TUDSSL/Botoks/hardware/Bill-of-materials.xlsx

Qty | Reference(s) | Value | Footprint | Datasheet | MPN | Digikey | Mouser
1 | AE1 | W3016 | jaspers_footprints:W3016 | https://productfinder.pulseeng.com/product/W3016 | W3016
20 | C1, C4, C5, C6, C7, C22, C23, C24, C27, C28, C29, C30, C31, C32, C33, C34, C37, C38, C44, C45 | 100nF | Capacitor_SMD:C_0402_1005Metric | ~ | GCM155R71C104KA55D | 490-4759-1-ND | 81-GCM155R71C104KA5D
6 | C2, C3, C17, C21, C39, C43 | DNP | Capacitor_SMD:C_0402_1005Metric | ~
2 | C8, C11 | 39pF | Capacitor_SMD:C_0402_1005Metric | ~ | 04025A390JAT2A | 478-1077-1-ND | 581-04025A390J
3 | C9, C10, C14 | 100pF | Capacitor_SMD:C_0402_1005Metric | ~ | GCM1555C1H101JA16D | 490-10669-1-ND | 81-GCM1555C1H101JA6D
2 | C12, C13 | 0.7pF | Capacitor_SMD:C_0402_1005Metric | ~ | 500R07S0R7AV4T | 712-1249-1-ND | 609-500R07S0R7AV4T
2 | C15, C18 | 2.2uF | Capacitor_SMD:C_0402_1005Metric | ~ | GRM155R61C225KE11D | 490-10695-1-ND | 81-GRM155R61C225KE1D
1 | C16 | C | Capacitor_SMD:C_0402_1005Metric | ~ | LQW15AN4N3G8ZD | 490-15466-1-ND
1 | C20 | 10u | Capacitor_SMD:C_0805_2012Metric | ~ | CL21A106KPFNNNG | 1276-6456-1-ND
1 | C35 | 2.2nF | Capacitor_SMD:C_0805_2012Metric | ~ | GRM2165C1H222FA01D | 490-6443-1-ND | 81-GRM2165C1H222FA1D
1 | C36 | 22nF | Capacitor_SMD:C_0805_2012Metric | ~ | GRM21B5C1H223JA01L | 490-1644-1-ND | 81-GRM215C1H223JA01L
1 | C25 | 220nF | Capacitor_SMD:C_0805_2012Metric | ~ | GCM21BR71H224KA37L | 490-4970-1-ND | 81-GCM21BR71H224K37L
1 | C26 | 2.2uF | Capacitor_SMD:C_0805_2012Metric | ~ | GCM21BR71E225KA73L | 490-4787-1-ND | 81-GCM21BR71E225KA3L
1 | C40 | 2.2nF | Capacitor_SMD:C_0402_1005Metric | ~ | GCM155R71H222KA37D | 490-4914-1-ND | 81-GCM155R71H222K37D
1 | C41 | 22uF | Capacitor_SMD:C_0603_1608Metric | ~ | GRM187R61A226ME15D | 490-13243-1-ND | 81-GRM187R61A226ME5D
1 | C42 | 100uF | Capacitor_SMD:C_0805_2012Metric | ~ | GRM21BR60J107ME15L | 490-13981-1-ND | 81-GRM21BR60J107ME5L
4 | D1, D2, D3, D4 | BAS40-02V-V-G-08 | Diode_SMD:D_SOD-523 | http://www.vishay.com/docs/82391/bas4002v.pdf | BAS40-02V-V-G-08 | BAS40-02V-V-G-08GICT-ND | 78-BAS40-02V-V-G-08
1 | F1 | SF16-0868M4 | jaspers_footprints:SF16-0868M4 | https://global.kyocera.com/prdct/electro/product/pdf/sf14_sf16_short.pdf | SF16-0868M4 | 478-6488-1-ND | 581-SF16-0868M4UU01
1 | J1 | 952-3602-ND | Connector_PinHeader_1.27mm:PinHeader_1x06_P1.27mm_Vertical | ~ | M50-3530642 | 952-3602-ND | 855-M50-3530642
1 | J2 | Conn_01x03 | Connector_PinHeader_1.00mm:PinHeader_1x03_P1.00mm_Vertical | ~ | SMH100-LPSE-S40-ST-BK | S9219-ND
2 | J3, J5 | Conn_01x02 | Connector_PinHeader_1.00mm:PinHeader_1x02_P1.00mm_Vertical | ~
1 | J4 | MM8030-2610 | jaspers_footprints:MM8030 |  | MM8030-2610 | 490-5907-1-ND‎ | 81-MM8030-2610RK0
2 | L1, L2 | 8.7nH | Inductor_SMD:L_0402_1005Metric | ~ | LQW15AN8N7G00D | 490-6851-1-ND | 81-LQW15AN8N7G00D
2 | L3, L4 | 39nH | Inductor_SMD:L_0402_1005Metric | ~ | LQW15AN39NG8ZD | 490-15413-1-ND | 81-LQW15AN39NG8ZD
1 | L5 | 19nH | Inductor_SMD:L_0402_1005Metric | ~ | LQW15AN19NG00D | 490-6778-1-ND | 81-LQW15AN19NG00D
1 | L6 | 7.5nH | Inductor_SMD:L_0402_1005Metric | ~ | LQW15AN7N5G00D | 490-6846-1-ND | 81-LQW15AN7N5G00D
1 | R1 | 49.9k ±1% | Resistor_SMD:R_0402_1005Metric | ~ | ERJ-2RKF4992X | P49.9KLCT-ND | 667-ERJ-2RKF4992X
11 | R2, R4, R5, R6, R7, R8, R11, R22, R23, R24, R25 | 10M | Resistor_SMD:R_0402_1005Metric | ~ | RC1005F106CS | 1276-3434-1-ND
5 | R9, R10, R26, R27, R37 | 100 | Resistor_SMD:R_0402_1005Metric | ~ | ERJ-2GEJ101X | P100JCT-ND | 667-ERJ-2GEJ101X
4 | R13, R14, R30, R31 | 22M | Resistor_SMD:R_0805_2012Metric | ~ | RMCF0805FT22M0 | RMCF0805FT22M0CT-ND
1 | R15 | 9.1M | Resistor_SMD:R_0402_1005Metric | ~ | ERJ-2GEJ915X | P9.1MJCT-ND | 667-ERJ-2GEJ915X
1 | R16 | 2.4M | Resistor_SMD:R_0402_1005Metric | ~ | ERJ-2GEJ245X | P2.4MJCT-ND | 667-ERJ-2GEJ245X
1 | R32 | 47k | Resistor_SMD:R_0402_1005Metric | ~ | ERJ-2GEJ473X | P47KJCT-ND | 667-ERJ-2GEJ473X
1 | R33 | 1.5M | Resistor_SMD:R_0402_1005Metric | ~ | ERJ-2GEJ155X | P1.5MJCT-ND | 667-ERJ-2GEJ155X
1 | R34 | 360k | Resistor_SMD:R_0402_1005Metric | ~ | ERJ-2RKF3603X | P360KLCT-ND | 667-ERJ-2RKF3603X
1 | R35 | 1.1M | Resistor_SMD:R_0402_1005Metric | ~ | AC0402FR-071M1L | YAG5647CT-ND | 603-AC0402FR-071M1L
1 | R36 | 10k | Resistor_SMD:R_0402_1005Metric | ~ | ERJ-2RKF1002X | P10.0KLCT-ND | 667-ERJ-2RKF1002X
1 | SC1 | KXOB25-02X8F | jaspers_footprints:KXOB25-02X8F | ~ | KXOB25-02X8F | KXOB25-02X8F-ND
2 | U1, U18 | S-1313A22-N4T1U3 | Package_TO_SOT_SMD:SC-82AB | https://www.ablic.com/en/doc/datasheet/voltage_regulator/S1313_E.pdf | S-1313A22-N4T1U3 | 1662-2988-1-ND | 628-S-1313A22-N4T1U3
1 | U2 | ZL70550 | jaspers_footprints:QFN-32-1EP_5x5mm_P0.5mm_EP3.45x3.45mm_ThermalVias_0.3mm_Drill | https://www.microsemi.com/document-portal/doc_download/135816-microsemi-zl70550-ultra-low-power-sub-ghz-rf-transceiver-datasheet | ZL70550LDF1 |  | 494-ZL70550LDF1
4 | U3, U6, U10, U14 | TS3A4751 | Package_DFN_QFN:Texas_S-PVQFN-N14_ThermalVias | http://www.ti.com/general/docs/lit/getliterature.tsp?genericPartNumber=ts3a4751&fileType=pdf | TS3A4751RGYR | 296-24477-1-ND | 595-TS3A4751RGYR
3 | U4, U11, U12 | SN74AUP2G79DCU | Package_SO:VSSOP-8_2.4x2.1mm_P0.5mm | http://www.ti.com/lit/ds/symlink/sn74aup2g79.pdf | SN74AUP2G79DCUR | 296-25598-1-ND | 595-SN74AUP2G79DCUR
2 | U5, U13 | SN74AUP2G00DCU | Package_SO:VSSOP-8_2.4x2.1mm_P0.5mm | http://www.ti.com/lit/ds/symlink/sn74aup2g00.pdf | SN74AUP2G00DCUR | 296-36884-1-ND | 595-SN74AUP2G00DCUR
1 | U7 | MCP1810T-12 | Package_TO_SOT_SMD:SOT-23-5 | http://ww1.microchip.com/downloads/en/DeviceDoc/20005623B.pdf | MCP1810T-12 | - | 579-MCP1810T12IOT
3 | U8, U9, U17 | TLV3691IDCK | jaspers_footprints:Texas_R-PDSO-G5 | http://www.ti.com/lit/ds/symlink/tlv3691.pdf | TLV3691IDCKR | 296-37910-1-ND | 595-TLV3691IDCKR
1 | U15 | MSP430FR5994IRGZ | Package_DFN_QFN:QFN-48-1EP_7x7mm_P0.5mm_EP5.15x5.15mm_ThermalVias | http://www.ti.com/lit/ds/symlink/msp430fr5994.pdf | MSP430FR5994IRGZ | 296-48940-1-ND | 595-P430FR5994IRGZR
1 | U16 | MIC841HYC5 | jaspers_footprints:SC70-5 | http://ww1.microchip.com/downloads/en/DeviceDoc/20005758A.pdf | MIC841HYC5-TR | 576-2923-1-ND | 998-MIC841HYC5TR
1 | Y1 | ECS-240-8-37CKM | jaspers_footprints:ECX-1637 | https://www.ecsxtal.com/store/pdf/ecx-1637.pdf | ECS-240-8-37CKM | XC1543CT-ND | 520-ECS-240-8-37CKM
