TUDSSL/Botoks/hardware/schematic/Botox_Mote.pdf

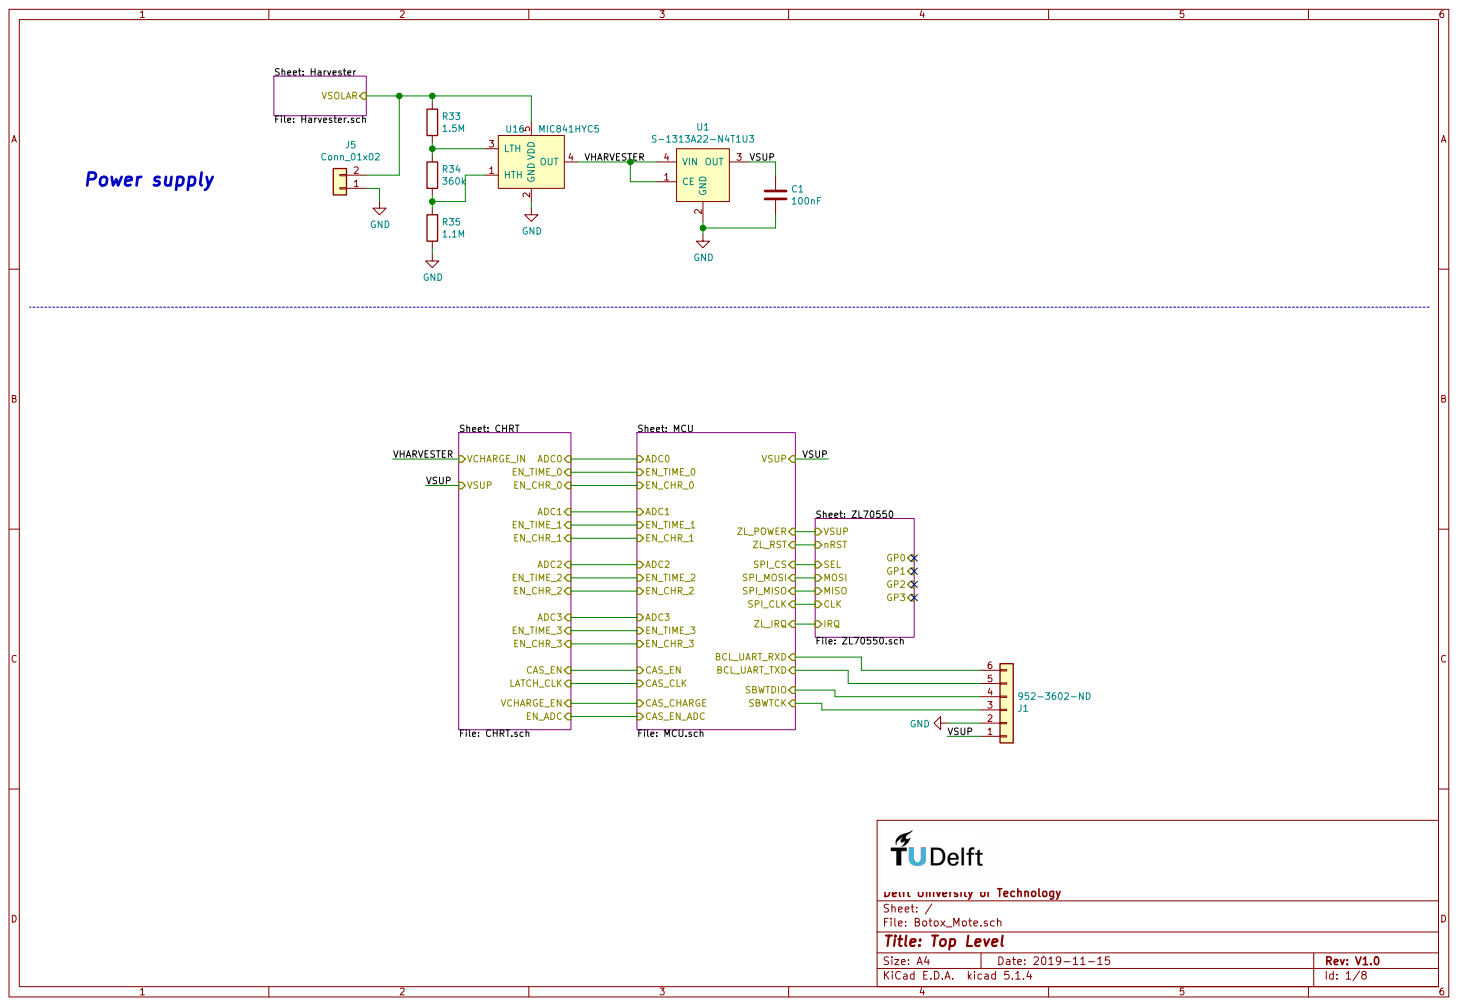
[picture p3: page 1]

Sheet: Harvester File: Harvester.sch VSOLAR

Sheet: ZL70550 File: ZL70550.sch MISO MOSI CLK
VSUP
SEL

File: Botox_Mote.sch Sheet: / Delft University of Technology

Id: 1/8 Title: Top Level

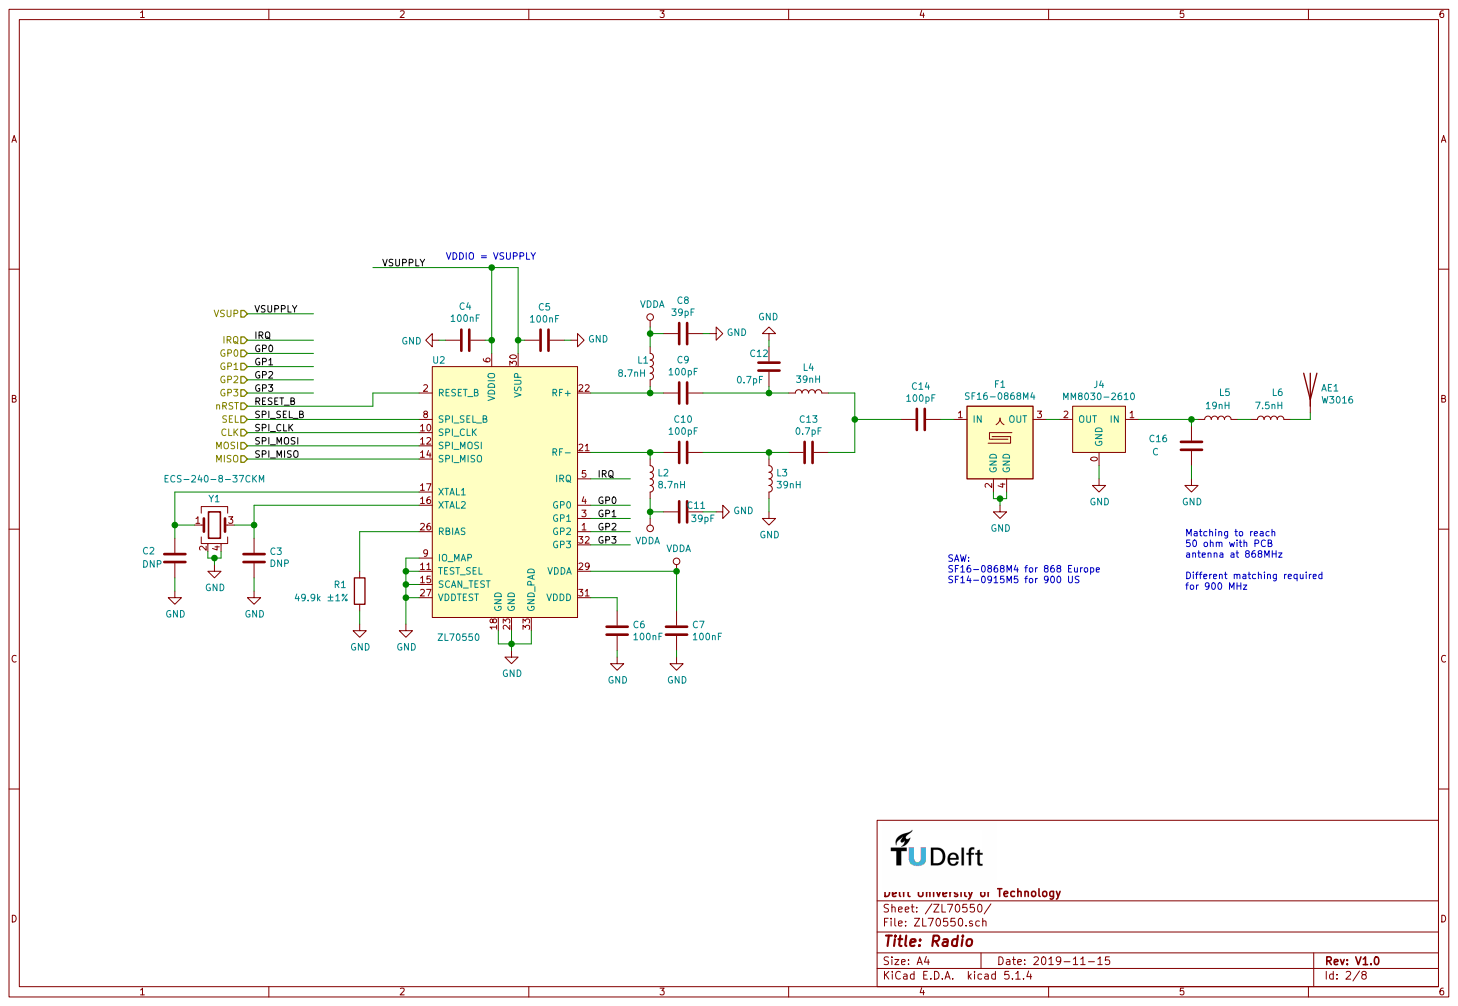
[picture p4: page 2]

for 900 MHz VDDIO = VSUPPLY

50 ohm with PCB
antenna at 868MHz Different matching required

SAW: SF16-0868M4 for 868 Europe SF14-0915M5 for 900 US

File: ZL70550.sch Sheet: /ZL70550/ Delft University of Technology GND

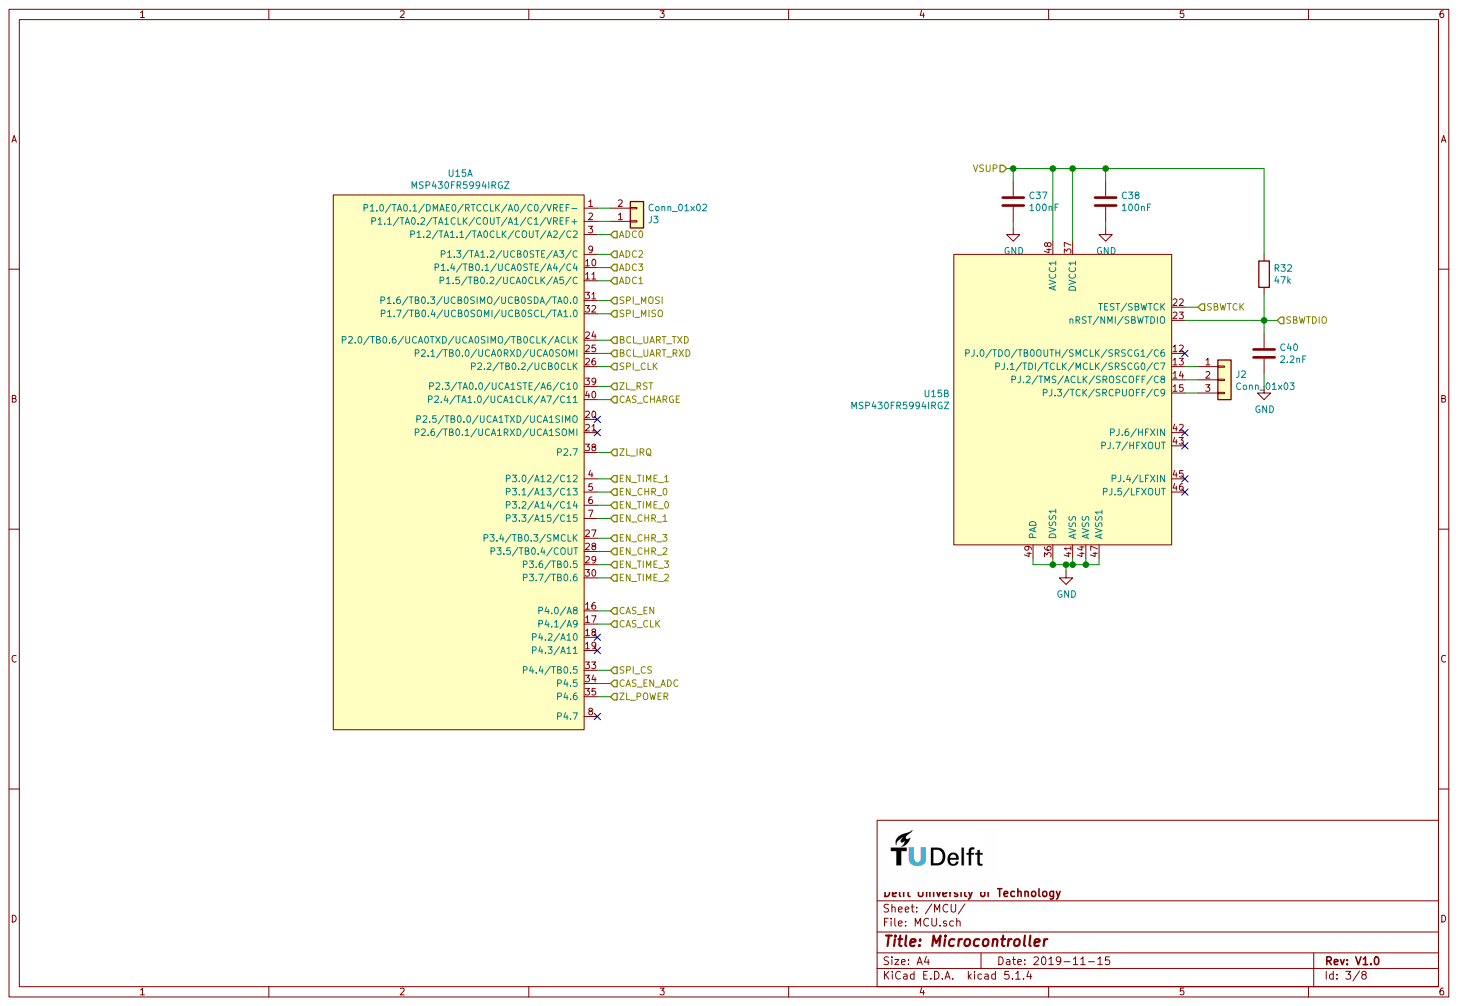
[picture p5: page 3]

Id: 3/8 Title: Microcontroller File: MCU.sch Sheet: /MCU/ Delft University of Technology

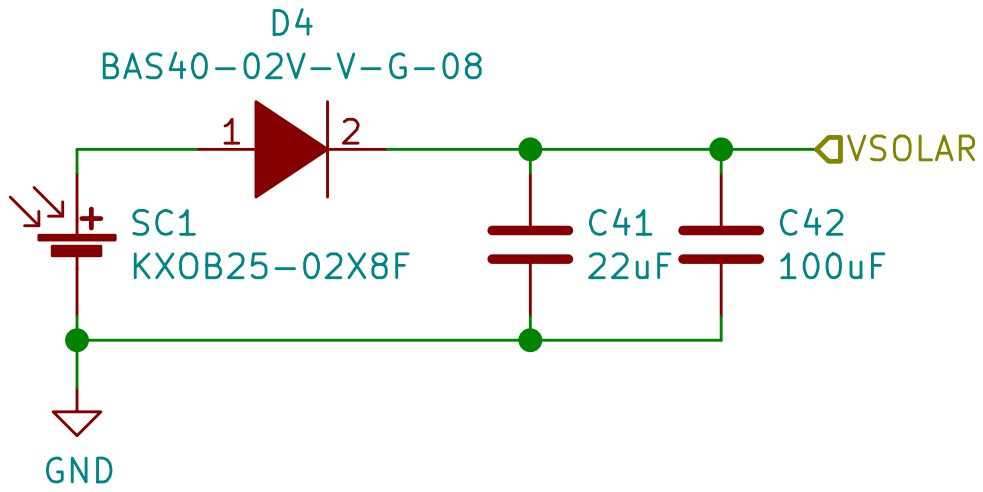
[picture p6: page 4]

Id: 4/8 Title: Solar Energy Harvester File: Harvester.sch Sheet: /Harvester/ Delft University of Technology

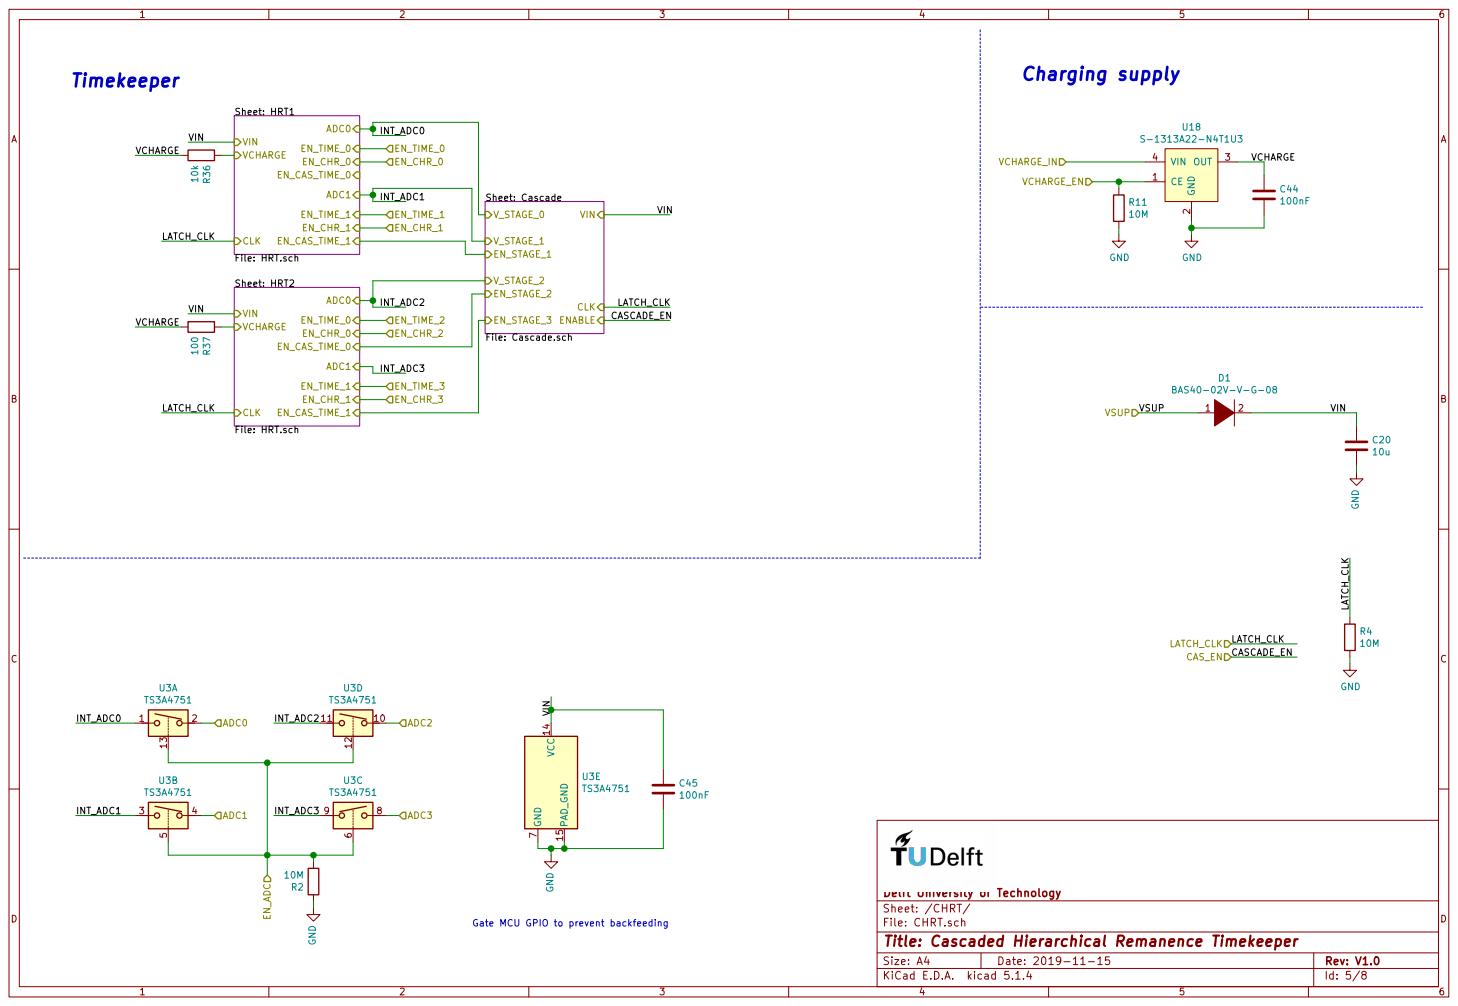
[picture p7: page 5]

Id: 5/8 Title: Cascaded Hierarchical Remanence Timekeeper File: CHRT.sch Sheet: /CHRT/ Delft University of Technology

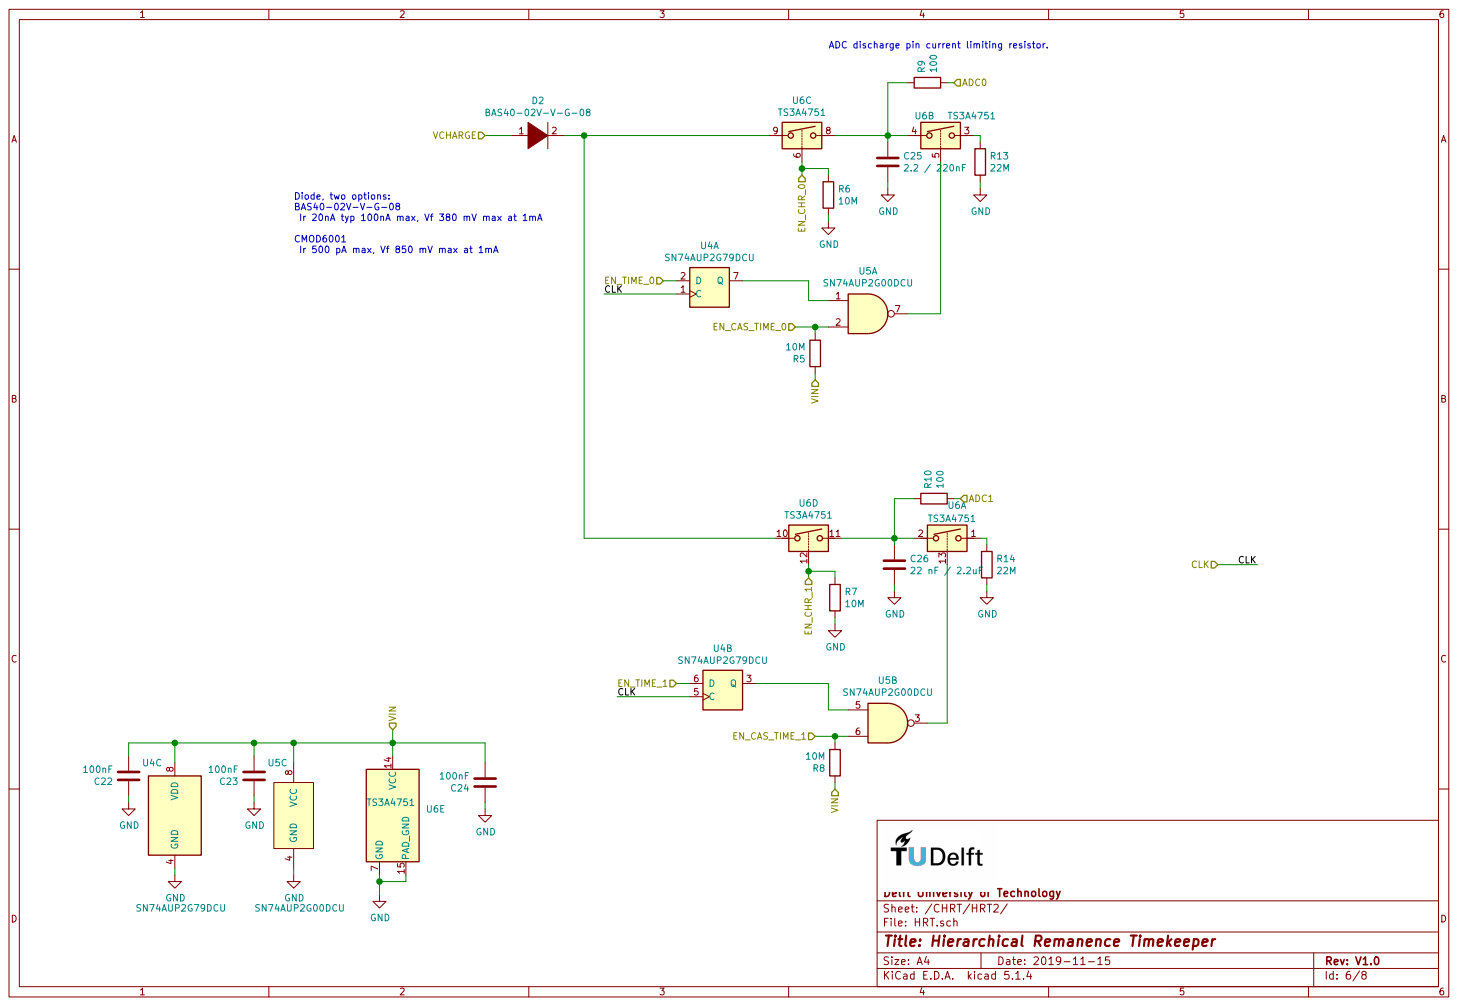
[picture p8: page 6]

Ir 20nA typ 100nA max, Vf 380 mV max at 1mA CMOD6001

Ir 500 pA max, Vf 850 mV max at 1mA

Id: 6/8 Title: Hierarchical Remanence Timekeeper File: HRT.sch Sheet: /CHRT/HRT2/ Delft University of Technology

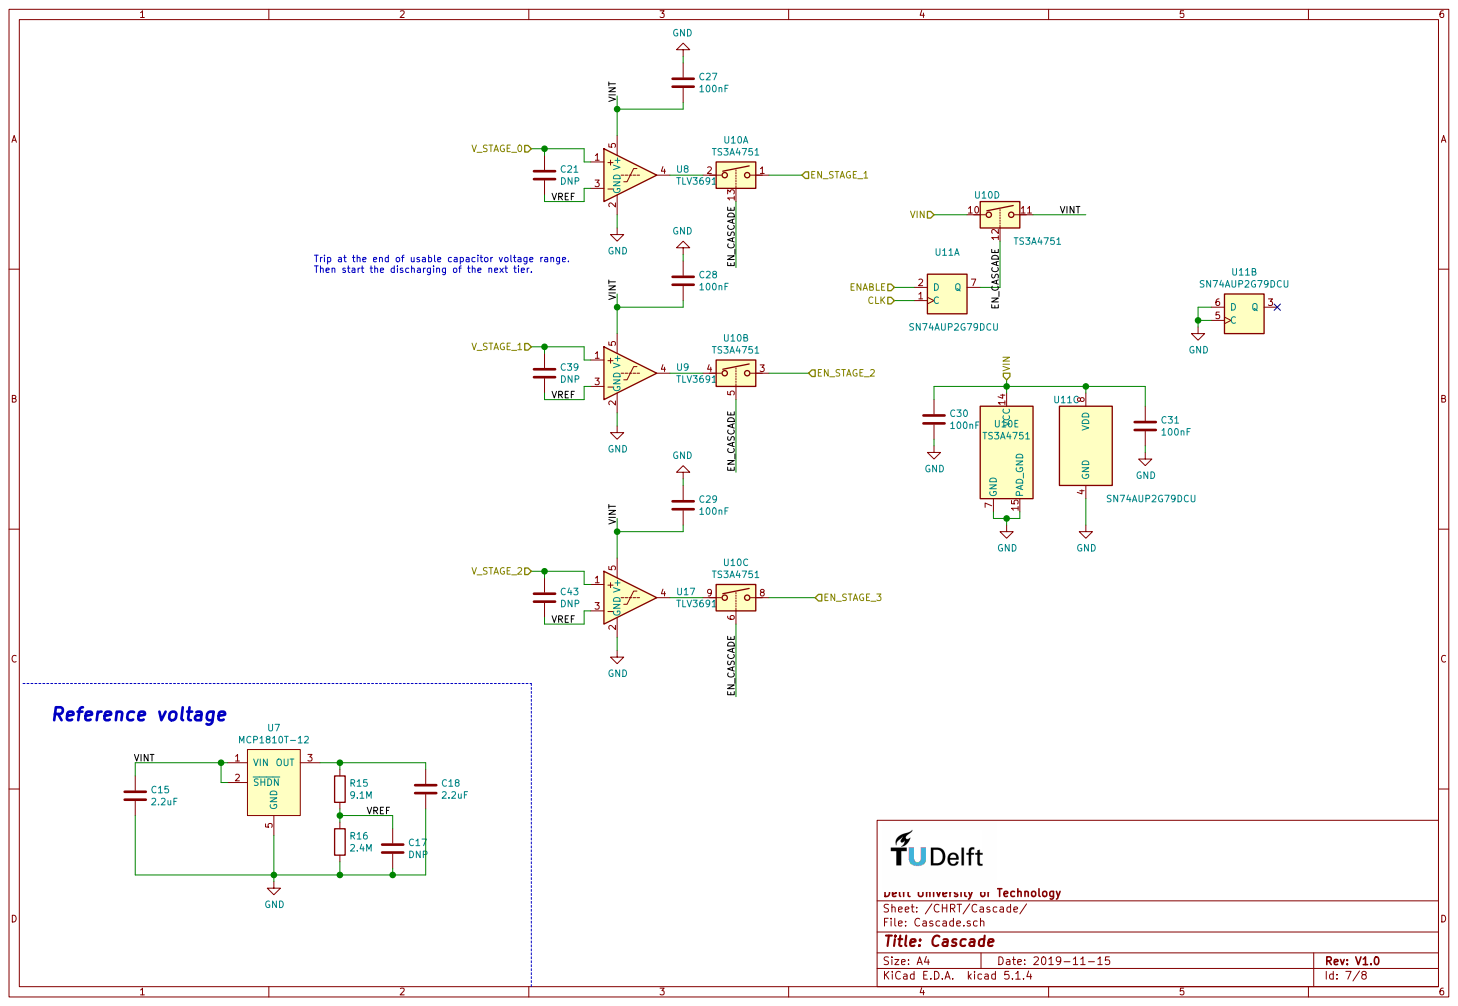
[picture p9: page 7]

Trip at the end of usable capacitor voltage range.
Then start the discharging of the next tier.

File: Cascade.sch Sheet: /CHRT/Cascade/ Delft University of Technology

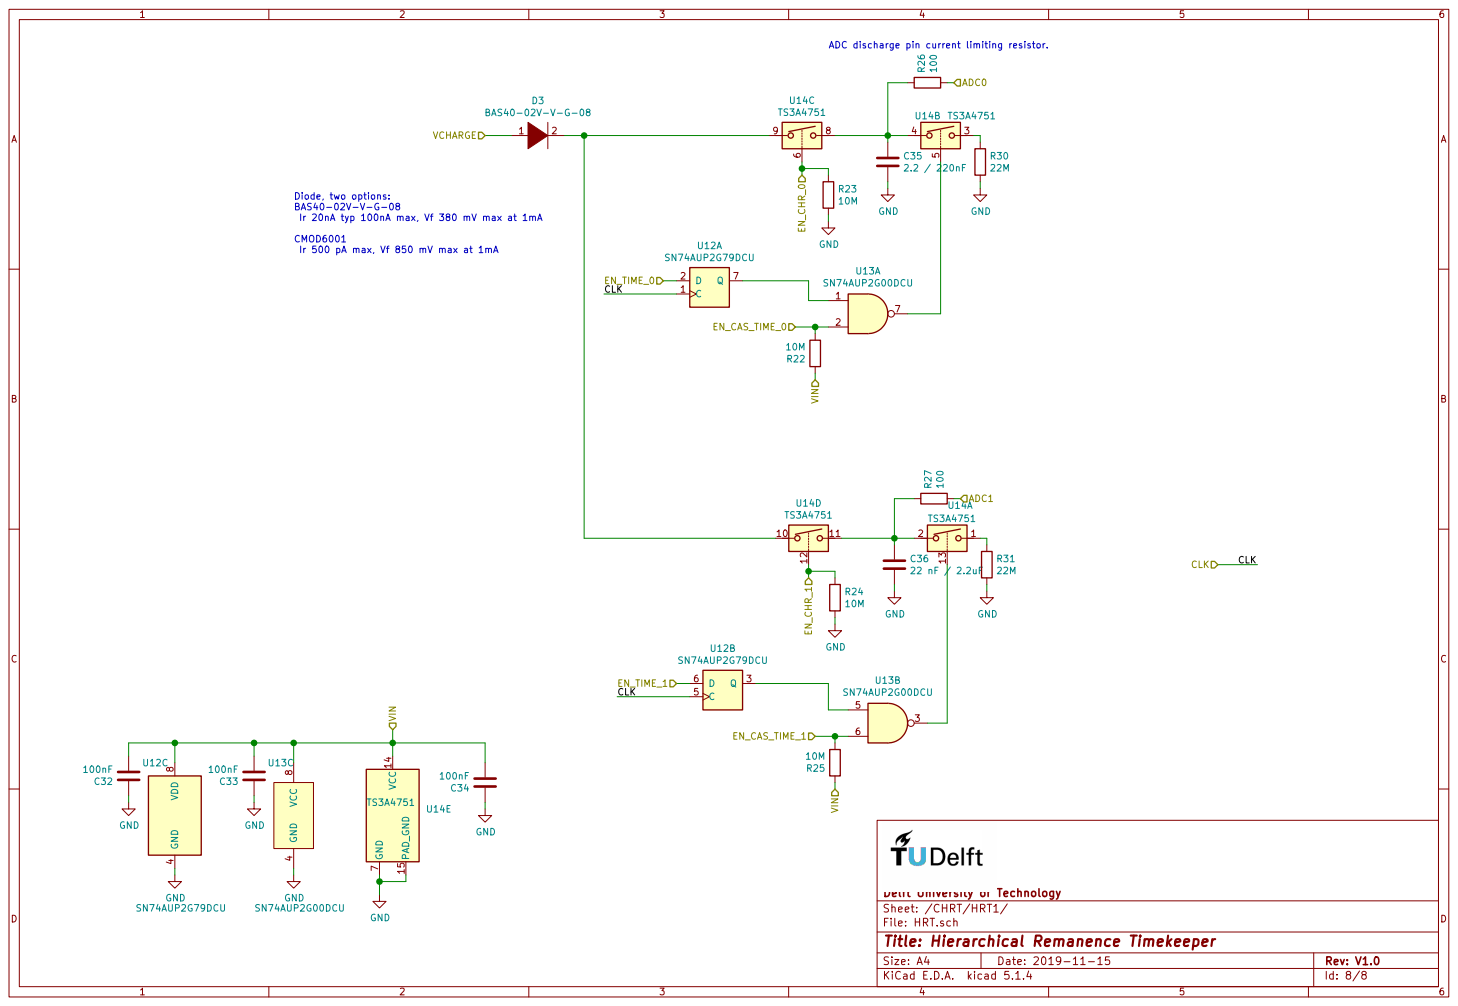
[picture p10: page 8]

Ir 20nA typ 100nA max, Vf 380 mV max at 1mA CMOD6001

Ir 500 pA max, Vf 850 mV max at 1mA

Id: 8/8 Title: Hierarchical Remanence Timekeeper File: HRT.sch Sheet: /CHRT/HRT1/ Delft University of Technology
