TUDSSL/Botoks/hardware/Botox_Mote.kicad_pcb

## KiCad design hardware/Botox_Mote.kicad_pcb (2020-01-19)

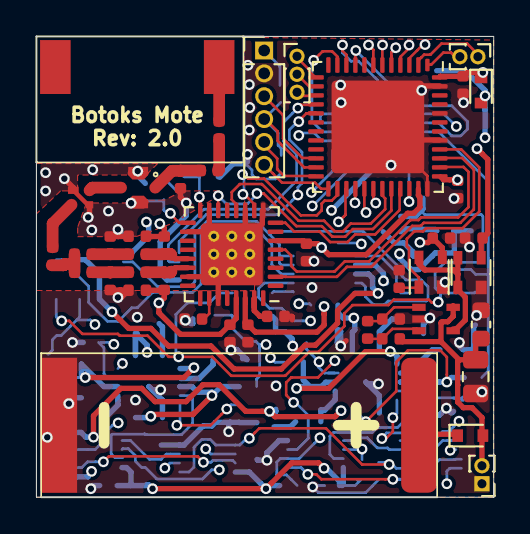
[picture p11: board Botox_Mote.kicad_pcb from above]

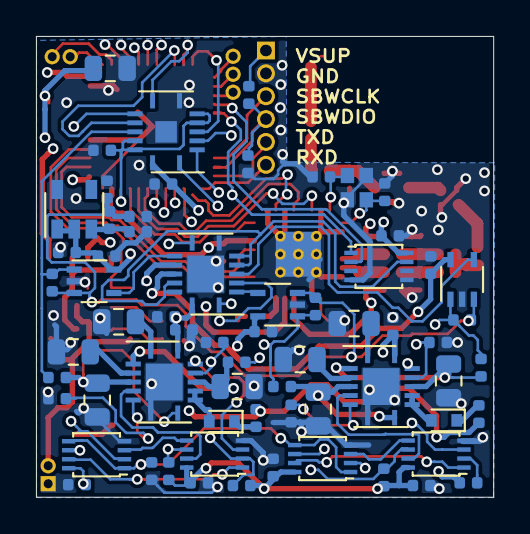
[picture p12: board Botox_Mote.kicad_pcb from below]

Board: 4 copper layers, 25.4 x 25.6 mm, 109 parts (65 on the bottom side), 91 nets.

Parts:
AE1: W3016
C1, C4, C5, C6, C7, C22, C23, C24, C27, C28, C29, C30, C31, C32, C33, C34, C37, C38, C44, C45: 100nF; C_0402_1005Metric
C2, C3, C17, C21, C39, C43: DNP; C_0402_1005Metric
C8, C11: 39pF; C_0402_1005Metric
C9, C10, C14: 100pF; C_0402_1005Metric
C12, C13: 0.7pF; C_0402_1005Metric
C15, C18: 2.2uF; C_0402_1005Metric
C16: C; C_0402_1005Metric
C20: 10u; C_0805_2012Metric
C25, C35: 2.2 / 220nF; C_0805_2012Metric
C26, C36: 22 nF / 2.2uF; C_0805_2012Metric
C40: 2.2nF; C_0402_1005Metric
C41: 22uF; C_0603_1608Metric
C42: 100uF; C_0805_2012Metric
D1, D2, D3, D4: BAS40-02V-V-G-08; D_SOD-523
F1: SF16-0868M4
J1: 952-3602-ND; PinHeader_1x06_P1.27mm_Vertical
J2: Conn_01x03; PinHeader_1x03_P1.00mm_Vertical
J3, J5: Conn_01x02; PinHeader_1x02_P1.00mm_Vertical
J4: MM8030-2610; MM8030
L1, L2: 8.7nH; L_0402_1005Metric
L3, L4: 39nH; L_0402_1005Metric
L5: 19nH; L_0402_1005Metric
L6: 7.5nH; L_0402_1005Metric
R1: 49.9k ±1%; R_0402_1005Metric
R2, R4, R5, R6, R7, R8, R11, R22, R23, R24, R25: 10M; R_0402_1005Metric
R9, R10, R26, R27, R37: 100; R_0402_1005Metric
R13, R14, R30, R31: 22M; R_0805_2012Metric
R15: 9.1M; R_0402_1005Metric
R16: 2.4M; R_0402_1005Metric
R32: 47k; R_0402_1005Metric
R33: 1.5M; R_0402_1005Metric
R34: 360k; R_0402_1005Metric
R35: 1.1M; R_0402_1005Metric
R36: 10k; R_0402_1005Metric
SC1: KXOB25-02X8F
U1, U18: S-1313A22-N4T1U3; SC-82AB
U2: ZL70550; QFN-32-1EP_5x5mm_P0.5mm_EP3.45x3.45mm_ThermalVias_0.3mm_Dri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
U3, U6, U10, U14: TS3A4751; Texas_S-PVQFN-N14
U4, U11, U12: SN74AUP2G79DCU; VSSOP-8_2.4x2.1mm_P0.5mm
U5, U13: SN74AUP2G00DCU; VSSOP-8_2.4x2.1mm_P0.5mm
U7: MCP1810T-12; SOT-23-5
U8, U9, U17: TLV3691IDCK; Texas_R-PDSO-G5
U15: MSP430FR5994IRGZ; QFN-48-1EP_7x7mm_P0.5mm_EP5.15x5.15mm
U16: MIC841HYC5; SC70-5
Y1: ECS-240-8-37CKM; ECX-1637

Connections:
/CHRT/ADC0: U3.2, U15.3
/CHRT/ADC1: U3.4, U15.11
/CHRT/ADC2: U3.10, U15.9
/CHRT/ADC3: U3.8, U15.10
/CHRT/CAS_EN: U11.2, U15.16
/CHRT/Cascade/EN_CASCADE: U10.5, U10.6, U10.12, U10.13, U11.7
/CHRT/Cascade/VINT: C15.1, C27.2, C28.2, C29.2, U7.1, U7.2, U8.5, U9.5, U10.11, U17.5
/CHRT/Cascade/VREF: C17.1, C21.2, C39.2, C43.2, R15.2, R16.1, U8.3, U9.3, U17.3
/CHRT/EN_CHR_0: R23.1, U14.6, U15.5
/CHRT/EN_CHR_1: R24.1, U14.12, U15.7
/CHRT/EN_CHR_2: R6.1, U6.6, U15.28
/CHRT/EN_CHR_3: R7.1, U6.12, U15.27
/CHRT/EN_TIME_0: U12.2, U15.6
/CHRT/EN_TIME_1: U12.6, U15.4
/CHRT/EN_TIME_2: U4.2, U15.30
/CHRT/EN_TIME_3: U4.6, U15.29
/CHRT/HRT1/EN_CAS_TIME_0: R22.2, U13.2
/CHRT/HRT1/EN_CAS_TIME_1: R25.2, U10.1, U13.6
/CHRT/HRT1/VCHARGE: D3.1, R36.1
/CHRT/HRT2/EN_CAS_TIME_0: R5.2, U5.2, U10.3
/CHRT/HRT2/EN_CAS_TIME_1: R8.2, U5.6, U10.8
/CHRT/HRT2/VCHARGE: D2.1, R37.1
/CHRT/INT_ADC0: C21.1, R26.2, U3.1, U8.1
/CHRT/INT_ADC1: C39.1, R27.2, U3.3, U9.1
/CHRT/INT_ADC2: C43.1, R9.2, U3.11, U17.1
/CHRT/INT_ADC3: R10.2, U3.9
/CHRT/VCHARGE: C44.1, R36.2, R37.2, U18.3
/CHRT/VIN: C20.1, C22.2, C23.2, C24.2, C30.1, C31.1, C32.2, C33.2, C34.2, C45.1, D1.2, R5.1, R8.1, R22.1, R25.1, U3.14, U4.8, U5.8, U6.14, U10.10, U10.14, U11.8, U12.8, U13.8, U14.14
/Harvester/VSOLAR: C41.1, C42.1, D4.2, J5.2, R33.1, U16.5
/MCU/BCL_UART_RXD: J1.6, U15.25
/MCU/BCL_UART_TXD: J1.5, U15.24
/MCU/CAS_CHARGE: R11.1, U15.40, U18.1
/MCU/CAS_CLK: R4.1, U4.1, U4.5, U11.1, U12.1, U12.5, U15.17
/MCU/CAS_EN_ADC: R2.2, U3.5, U3.6, U3.12, U3.13, U15.34
/MCU/SBWTCK: J1.3, U15.22
/MCU/SBWTDIO: C40.1, J1.4, R32.2, U15.23
/MCU/ZL_RST: U2.2, U15.39
/VHARVESTER: U1.1, U1.4, U16.4, U18.4
/VSUP: C1.1, C37.1, C38.1, D1.1, J1.1, R32.1, U1.3, U15.37, U15.48
/ZL70550/CLK: U2.10, U15.26
/ZL70550/IRQ: U2.5, U15.38
/ZL70550/MISO: U2.14, U15.32
/ZL70550/MOSI: U2.12, U15.31
/ZL70550/SEL: U2.8, U15.33
/ZL70550/VSUP: C4.2, C5.2, U2.6, U2.30, U15.35
GND: C1.2, C2.1, C3.1, C4.1, C5.1, C6.2, C7.2, C8.1, C11.1, C12.1, C15.2, C16.1, C17.2, C18.2, C20.2, C22.1, C23.1, C24.1, C25.2, C26.2, C27.1, C28.1, C29.1, C30.2, C31.2, C32.1, C33.1, C34.1, C35.2, C36.2, C37.2, C38.2, C40.2, C41.2, C42.2, C44.2, C45.2, F1.2, F1.4, J1.2, J4.0, J5.1, L3.2, R1.2, R2.1, R4.2, R6.2, R7.2, R11.2, R13.2, R14.2, R16.2, R23.2, R24.2, R30.2, R31.2, R35.2, SC1.2, U1.2, U2.9, U2.11, U2.15, U2.18, U2.23, U2.27, U2.33, U3.7, U3.15, U4.4, U5.4, U6.7, U6.15, U7.5, U8.2, U9.2, U10.7, U10.15, U11.4, U11.5, U11.6, U12.4, U13.4, U14.7, U14.15, U15.36, U15.41, U15.44, U15.47, U15.49, U16.2, U17.2, U18.2, Y1.2, Y1.4
unnamed: AE1.1, L6.2
unnamed: C2.2, U2.17, Y1.1
unnamed: C3.2, U2.16, Y1.3
unnamed: C6.1, U2.31
unnamed: C9.2, L1.2, U2.22
unnamed: C10.1, C13.2, L3.1
unnamed: C10.2, L2.1, U2.21
unnamed: C9.1, C12.2, L4.1
unnamed: C13.1, C14.2, L4.2
unnamed: C14.1, F1.1
unnamed: C16.2, J4.1, L5.1
unnamed: C18.1, R15.1, U7.3
unnamed: C25.1, R9.1, U6.4, U6.8
unnamed: C26.1, R10.1, U6.2, U6.11
unnamed: C35.1, R26.1, U14.4, U14.8
unnamed: C36.1, R27.1, U14.2, U14.11
unnamed: D2.2, U6.9, U6.10
unnamed: D3.2, U14.9, U14.10
unnamed: D4.1, SC1.1
unnamed: F1.3, J4.2
unnamed: J2.1, U15.13
unnamed: J2.2, U15.14
unnamed: J2.3, U15.15
unnamed: J3.1, U15.2
unnamed: J3.2, U15.1
unnamed: L5.2, L6.1
unnamed: R1.1, U2.26
unnamed: R13.1, U6.3
unnamed: R14.1, U6.1
unnamed: R30.1, U14.3
unnamed: R31.1, U14.1
unnamed: R33.2, R34.1, U16.3
unnamed: R34.2, R35.1, U16.1
unnamed: U4.3, U5.5
unnamed: U4.7, U5.1
unnamed: U5.3, U6.13
unnamed: U5.7, U6.5
unnamed: U8.4, U10.2
unnamed: U9.4, U10.4
unnamed: U10.9, U17.4
unnamed: U12.3, U13.5
unnamed: U12.7, U13.1
unnamed: U13.3, U14.13
unnamed: U13.7, U14.5
VDDA: C7.1, C8.2, C11.2, L1.1, L2.2, U2.29
