TUDSSL/Botoks/platforms/dev_board.h

#ifndef INCLUDE_devboard_H
#define INCLUDE_devboard_H

// For logic analyzer
#define PRF_PORT 4

#define RADIO_PIN 2
#define RX_PKT_PIN 3
#define DELAY_PIN 7

#define DBG_PORT 2
#define DEBUG_B 6
#define DBG_PWR_PORT 4
#define DEBUG_POWER_PIN 1

// timer pins
// GPIO pins
#define ADC_PORT 1
#define ADC_PIN_0 2
#define ADC_PIN_1 3
#define ADC_PIN_2 4
#define ADC_PIN_3 5

#define ADC_CHANNEL_PREFIX ADC12INCH_
#define ADC_CHANNEL_0 CONCAT(ADC_CHANNEL_PREFIX, ADC_PIN_0)
#define ADC_CHANNEL_1 CONCAT(ADC_CHANNEL_PREFIX, ADC_PIN_1)
#define ADC_CHANNEL_2 CONCAT(ADC_CHANNEL_PREFIX, ADC_PIN_2)
#define ADC_CHANNEL_3 CONCAT(ADC_CHANNEL_PREFIX, ADC_PIN_3)

#define CHARGE_PORT 3
#define CHARGE_PIN_0 0
#define CHARGE_PIN_1 2
#define CHARGE_PIN_2 4
#define CHARGE_PIN_3 6

// #define TIME_EN_PORT   3
// #define TIME_EN_PIN_0  1
// #define TIME_EN_PIN_1  3
// #define TIME_EN_PIN_2  5
// #define TIME_EN_PIN_3  7

#define TIME_EN_PORT 6
#define TIME_EN_PIN_0 0
#define TIME_EN_PIN_1 1
#define TIME_EN_PIN_2 2
#define TIME_EN_PIN_3 3

#define CAS_PORT 8
#define CAS_CLK_PIN 1
#define CAS_EN_PIN 2

#define CAS_LDO_PORT 3
#define CAS_LDO_EN 7

#define CAS_EN_ADC_PORT 7
#define CAS_EN_ADC_EN 3

// radio pins
#define zl70550_POWER_PORT 8
#define zl70550_POWER_PIN 3
// CSn pin
#define zl70550_CSn_PORT 5
#define zl70550_CSn_PIN 3

#define zl70550_RESETn_PORT 5
#define zl70550_RESETn_PIN 7

#define zl70550_IRQ_PORT 4
#define zl70550_IRQ_PIN 4

#define SPI_MOSI_PORT 5
#define SPI_MOSI_PIN 0
#define SPI_MISO_PORT 5
#define SPI_MISO_PIN 1
#define SPI_CLK_PORT 5
#define SPI_CLK_PIN 2
#define SPI_CS_PORT 5
#define SPI_CS_PIN 3

#endif /* INCLUDE_devboard_H */
